frank26080115/LedStripCarHud/readme.md

## LED Strip Car HUD ##

A car **H**eads **U**p **D**isplay built using a RGB LED strip and a Teensy microcontroller

Full project details at http://eleccelerator.com/car-hud

License: GPL v3, see LICENSE.txt
