frank26080115/LedStripCarHud/electrical/schematic.png

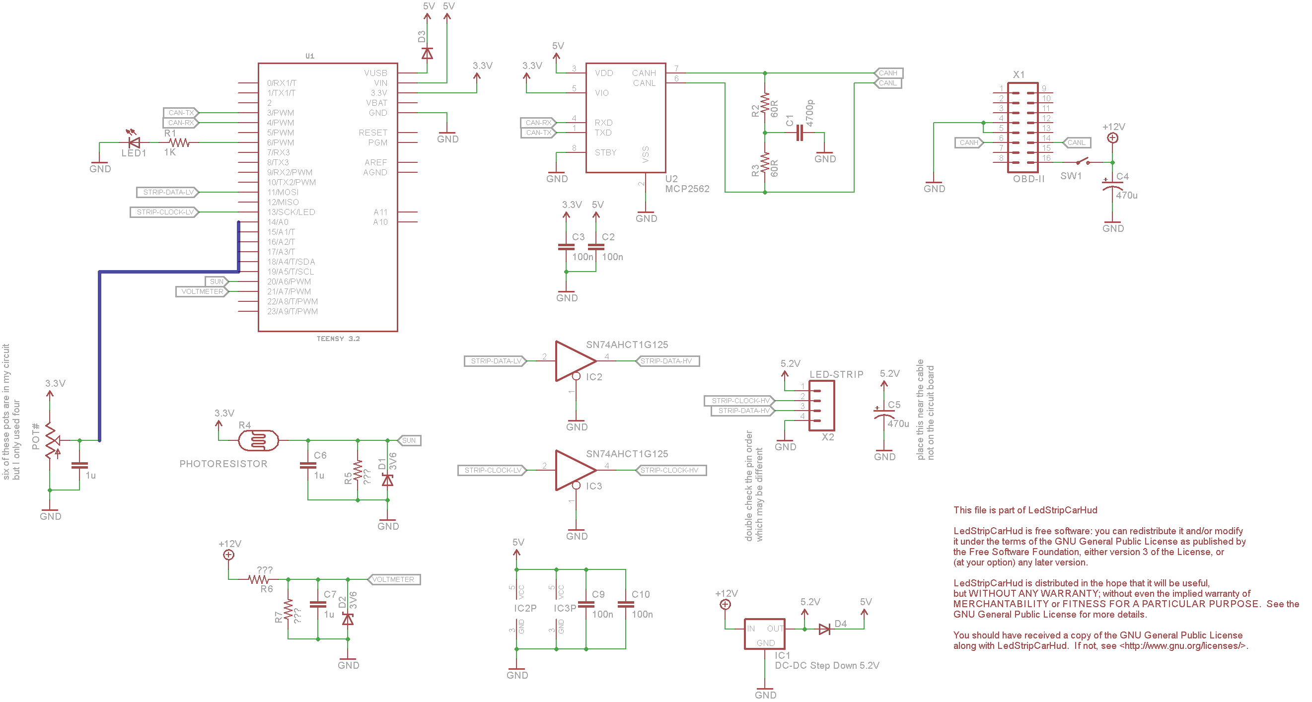
electrical/schematic.png
