frank26080115/LedStripCarHud/mechanical/mask.SLDPRT

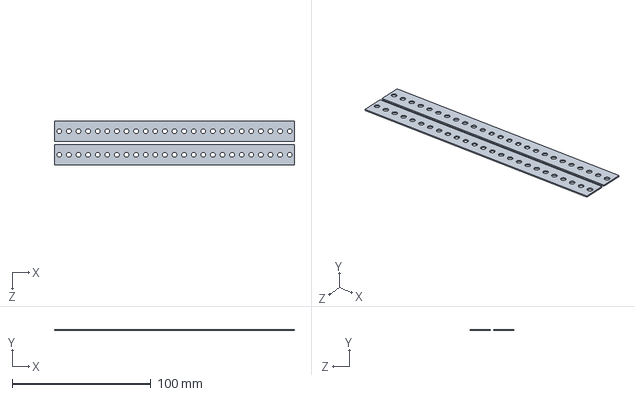
[picture p2: CAD file, 2017-06-27]
mechanical/mask.SLDPRT
172.7 x 0.8 x 32.0 mm
