frank26080115/LedStripCarHud/mechanical/box.SLDPRT

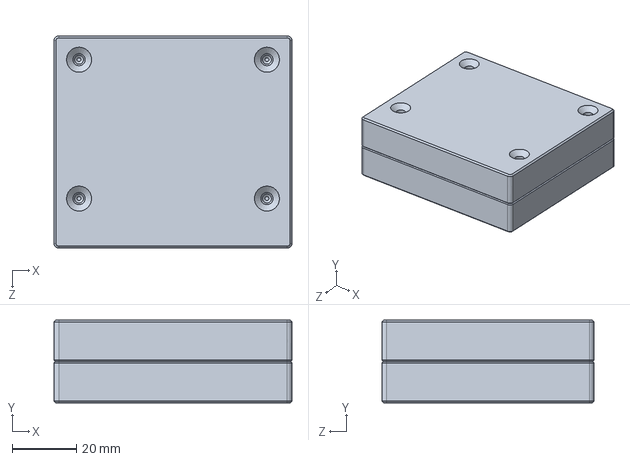
[picture p3: CAD file, 2017-06-25]
mechanical/box.SLDPRT
74.0 x 25.8 x 66.0 mm
