frank26080115/LedStripCarHud/mechanical/Assem1.STEP

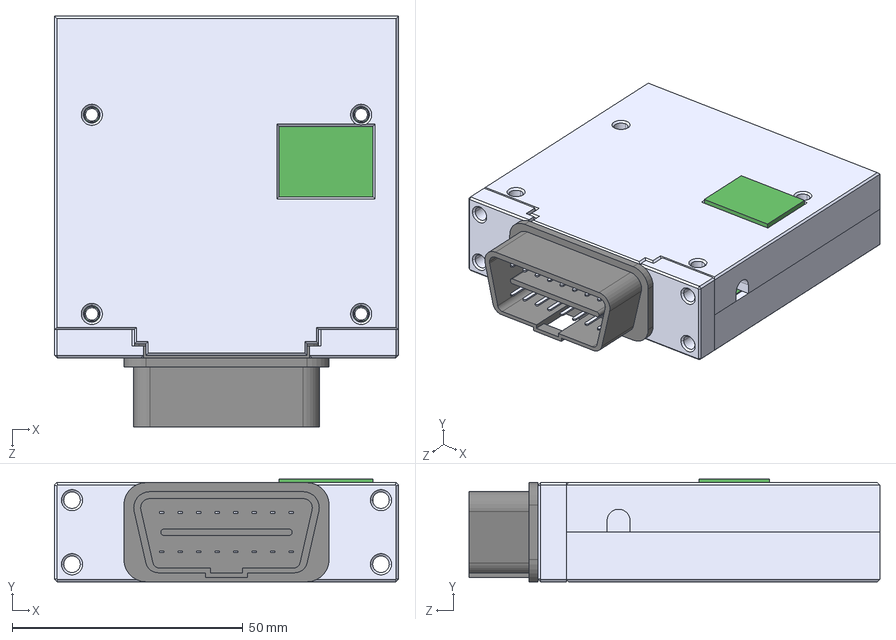
[picture p4: CAD file, 2017-06-25]
mechanical/Assem1.STEP
74.6 x 22.3 x 89.1 mm
obd2 connector model 1
perfboard
box^Assem1
lid^Assem1
