frank26080115/LedStripCarHud/mechanical/shroud_half.STEP

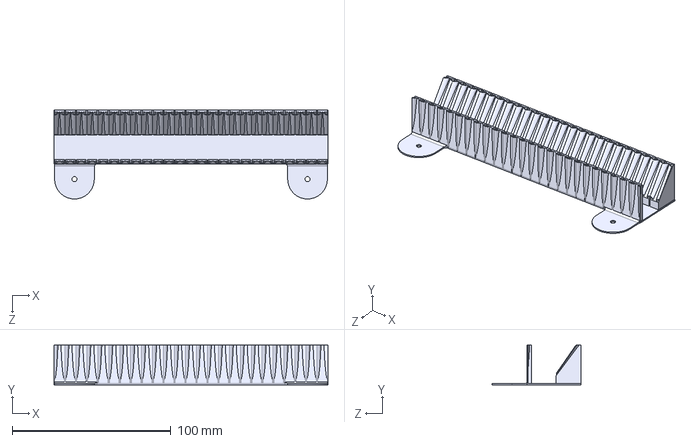
[picture p5: CAD file, 2017-06-25]
mechanical/shroud_half.STEP
172.7 x 25.0 x 56.1 mm
