frank26080115/LedStripCarHud/mechanical/obd2 connector model 1.SLDPRT

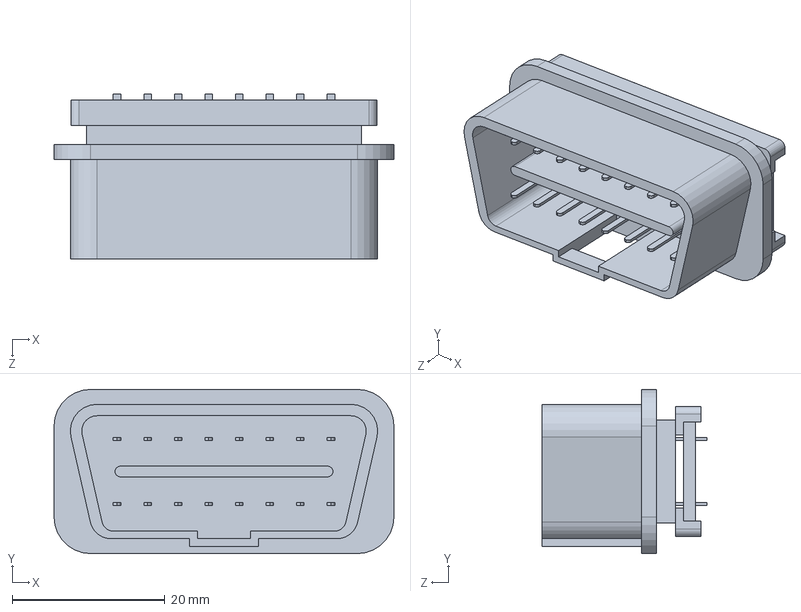
[picture p6: CAD file, 2017-06-10]
mechanical/obd2 connector model 1.SLDPRT
44.5 x 21.5 x 21.6 mm
