frank26080115/LedStripCarHud/mechanical/perfboard.SLDPRT

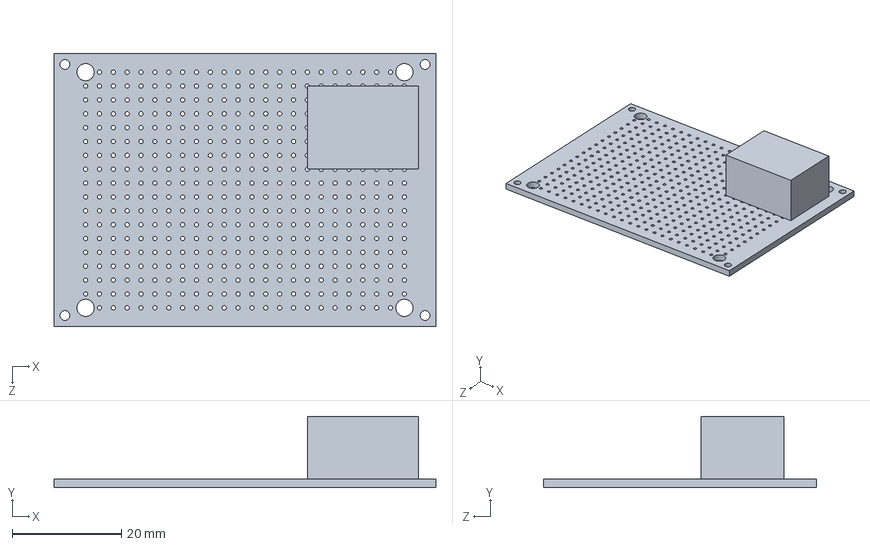
[picture p7: CAD file, 2017-06-10]
mechanical/perfboard.SLDPRT
70.0 x 13.1 x 50.0 mm
