frank26080115/LedStripCarHud/(list of files, cad)

Other CAD files:
mechanical/Assem1.SLDASM
mechanical/shroud_half.IGS
mechanical/shroud_half.SLDPRT
