frank26080115/LedStripCarHud/electrical/ledstripcarhud.sch

## EAGLE design electrical/ledstripcarhud.sch (2017-07-05)

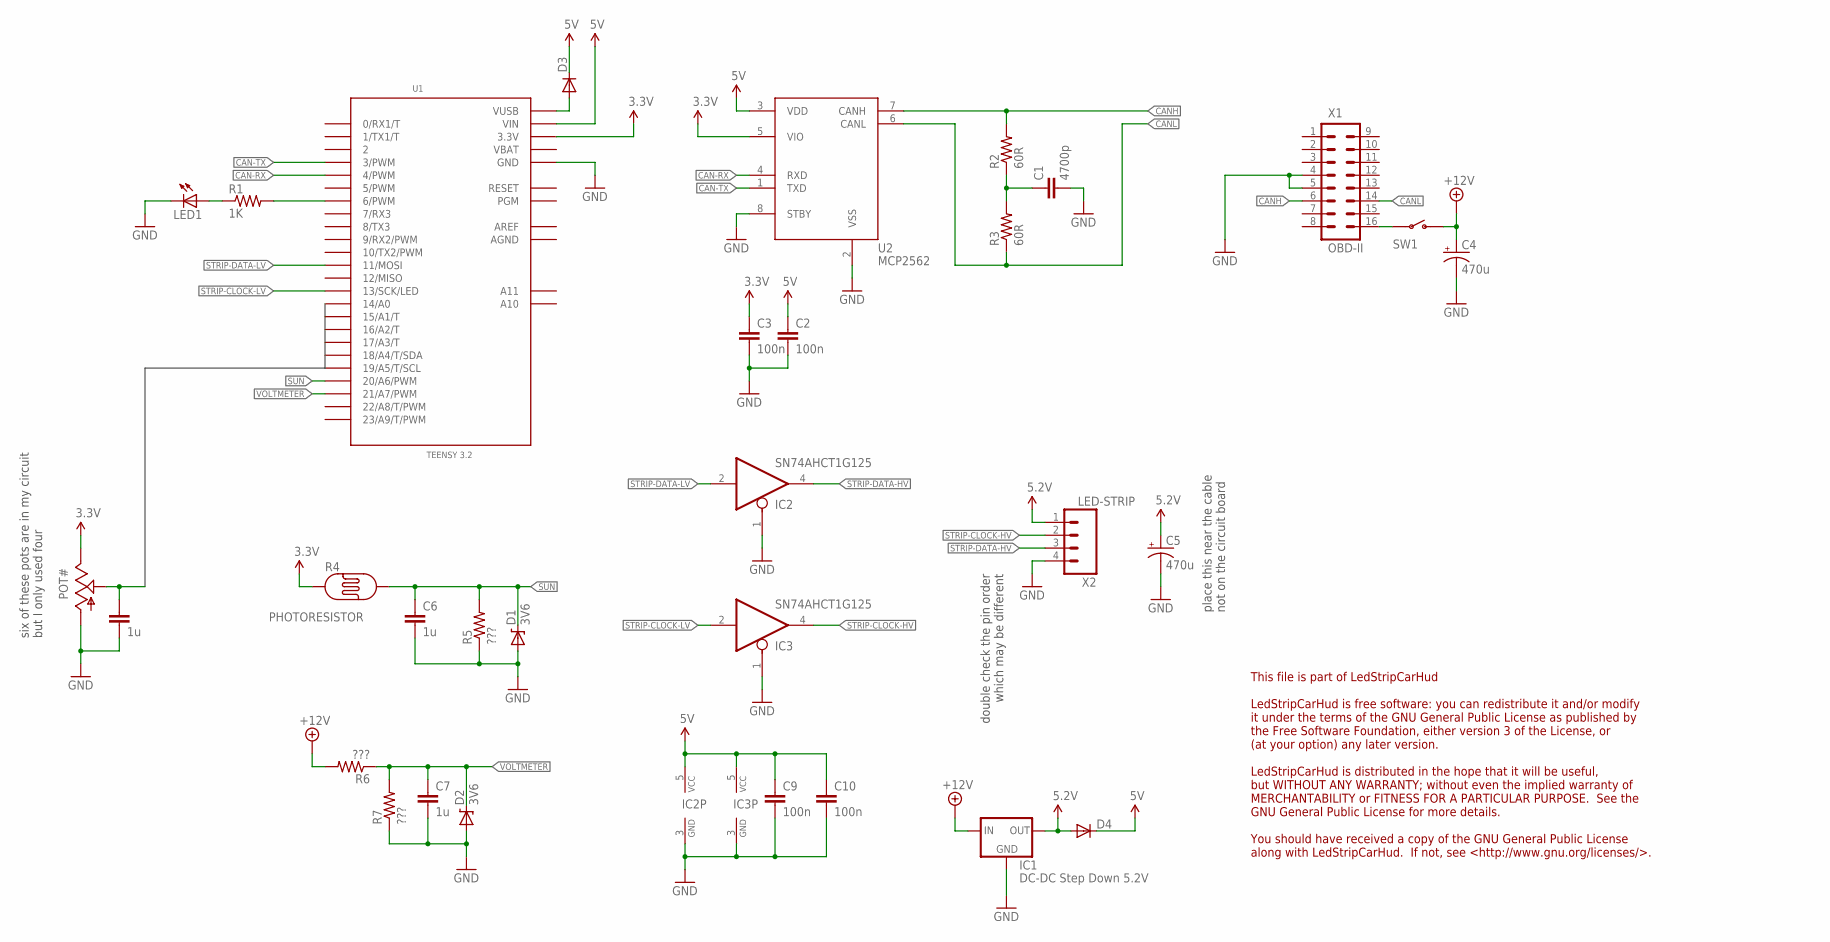
[picture p8: schematic ledstripcarhud.sch]

Parts:
C1: 4700p; 0603-CAP
C2, C3, C9, C10: 100n; 0603-CAP
C4, C5: 470u; PANASONIC_E
C6, C7, C8: 1u; 0603-CAP
D1, D2: 3V6; SOD-323
D3, D4: DIODE1N4148; DIODE-1N4148
IC1: DC-DC Step Down 5.2V; 78XXL
IC2, IC3: SN74AHCT1G125; SOT23-5
LED1: LED3MM
POT#: POTTRIM; TRIM_POT
R1: 1K; 0603-RES
R2, R3: 60R; 0603-RES
R4: PHOTORESISTOR; PHOTOCELL
R5, R6, R7: ???; 0603-RES
SW1: SWITCH-SPST-2RA; R_SW_TH
U1: TEENSY 3.2; TEENSY_3.0-3.2&LC_ALL_PINS
U2: MCP2562; DIL08
X1: OBD-II; 2X8
X2: LED-STRIP; 1X04

Connections:
3.3V: C3.1, POT#.2 (E), R4.1, U1.3.3V, U2.5 (VIO)
5V: C2.1, C5.+, C9.1, C10.1, D3.C, D4.A, D4.C, IC1.GND (OUT), IC2.5 (VCC), IC3.5 (VCC), U1.VIN, U2.3 (VDD), X2.1
+12V: C4.+, IC1.OUT (IN), R6.2, SW1.P$3 (O)
CAN-RX: U1.4 (4/PWM), U2.4 (RXD)
CAN-TX: U1.3 (3/PWM), U2.1 (TXD)
CANH: R2.2, U2.7 (CANH), X1.6
CANL: R3.1, U2.6 (CANL), X1.14
GND: C1.2, C2.2, C3.2, C4.-, C5.-, C6.2, C7.2, C8.2, C9.2, C10.2, D1.2 (A), D2.2 (A), IC1.IN (GND), IC2.1 (OE), IC2.3 (GND), IC3.1 (OE), IC3.3 (GND), LED1.K (C), POT#.3 (A), R5.1, R7.1, U1.GND, U2.2 (VSS), U2.8 (STBY), X1.4, X1.5, X2.4
unnamed: R1.2, U1.6 (6/PWM)
unnamed: LED1.A, R1.1
unnamed: C8.1, POT#.1 (S)
unnamed: SW1.P$4, X1.16
unnamed: D3.A, U1.VUSB
unnamed: C1.1, R2.1, R3.2
STRIP-CLOCK-HV: IC3.4 (O), X2.2
STRIP-CLOCK-LV: IC3.2 (I), U1.13 (13/SCK/LED)
STRIP-DATA-HV: IC2.4 (O), X2.3
STRIP-DATA-LV: IC2.2 (I), U1.11 (11/MOSI)
SUN: C6.1, D1.1 (C), R4.2, R5.2, U1.20/A6 (20/A6/PWM)
VOLTMETER: C7.1, D2.1 (C), R6.1, R7.2, U1.21/A7 (21/A7/PWM)

Notes on the sheet:
place this near the cable not on the circuit board
double check the pin order which may be different
six of these pots are in my circuit but I only used four
This file is part of LedStripCarHud LedStripCarHud is free software: you can redistribute it and/or modify it under the terms of the GNU General Public License as published by the Free Software Foundation, either version 3 of the License, or (at your option) any later version. LedStripCarHud is dis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
