frank26080115/LedStripCarHud/(commit log)

2017-06-10 initial work in progress upload with readmes
    [Assem1.SLDASM, obd2 connector model 1.SLDPRT, perfboard.SLDPRT]
2017-06-10 update from second computer
    shorter strip config, fixed brightness filter to avoid overflow, added
    fading head logic
    [brightness.ino, config.h, draw.ino, ledstrip.ino]
2017-06-12 corrected pin naming convention, compiles
    [hw.h]
2017-06-12 minor syntax fixes for compile
    [brightness.ino, ledstrip.ino, voltage.ino]
2017-06-12 canbus.ino better readability and flexibility
2017-06-12 prep for bring up, integrate new funcs, correct syntax
    [LedStripCarHud.ino, config.h]
2017-06-13 map func had a bug that flipped the scaling
    [calc.ino]
2017-06-13 tested analog readings of voltage input
2017-06-14 integrate snooze library for power saving, untested
2017-06-14 canbus funcs more flexible, accepts null pointers
2017-06-19 seperated all analog reads to a master polling task
    added continuous automatic filtering
2017-06-19 better reflection of real hardware
    included pedal auto calibration
2017-06-19 removing estimation of current gear, useless
2017-06-19 CAN bus reading use latest library with callbacks
2017-06-19 revamped ledstrip.ino to use only fastled, added funcs and virtual blanking
2017-06-20 dimming during voltmeter was annoying
2017-06-20 possible fix for glitchy strip
    [ledstrip.ino]
2017-06-20 circuit change requires re-calib
2017-06-20 added schematic
    [ledstripcarhud.sch]
2017-06-20 added level shifters to schematic
    [ledstripcarhud.sch]
2017-06-21 fixed 2 speedometer display bugs
    [config.h, defs.h, draw.ino]
2017-06-21 attempt to fix a wake up display bug
    [LedStripCarHud.ino]
2017-06-21 easier to fix wake bug if I just reboot
    [LedStripCarHud.ino, hw.h]
2017-06-22 trying to fix wake up animation bugs
    CPU reset command didn't work
    [LedStripCarHud.ino, hw.h]
2017-06-22 full reset of millis counter when waking
    unknown if this helps
    [LedStripCarHud.ino]
2017-06-23 fixed fading of over 80MPH tail
    [draw.ino]
2017-06-23 added auto power limit to prevent glitchy strip
    should also keep the DC-DC converter cooler
    [hw.h, ledstrip.ino, tests.ino]
2017-06-23 safer timer reset during wakeup
    [shroud v5.SLDPRT]
2017-06-25 bug fix speedo, found while test driving
    I am an idiot lol
    [draw.ino, ledstrip.ino]
2017-06-25 shroud design finalized
    [shroud_half.IGS, shroud_half.SLDPRT, shroud_half.STEP]
2017-06-25 box design step and iges, minor hole change
    [Assem1.SLDASM, Assem1.STEP]
2017-06-25 updated a hole size
    [box.SLDPRT]
2017-06-25 unwanted files
    [shroud v5.SLDPRT]
2017-06-25 add note about removing LED from Teensy
2017-06-27 LED mask first draft
    [mask.SLDPRT]
2017-07-05 added GPL text to everything
    [ledstripcarhud.sch]
